lambdamikel/microtronic-2095-arduino-emulator/images/Arduino_UNO_R3_Pinout.jpg

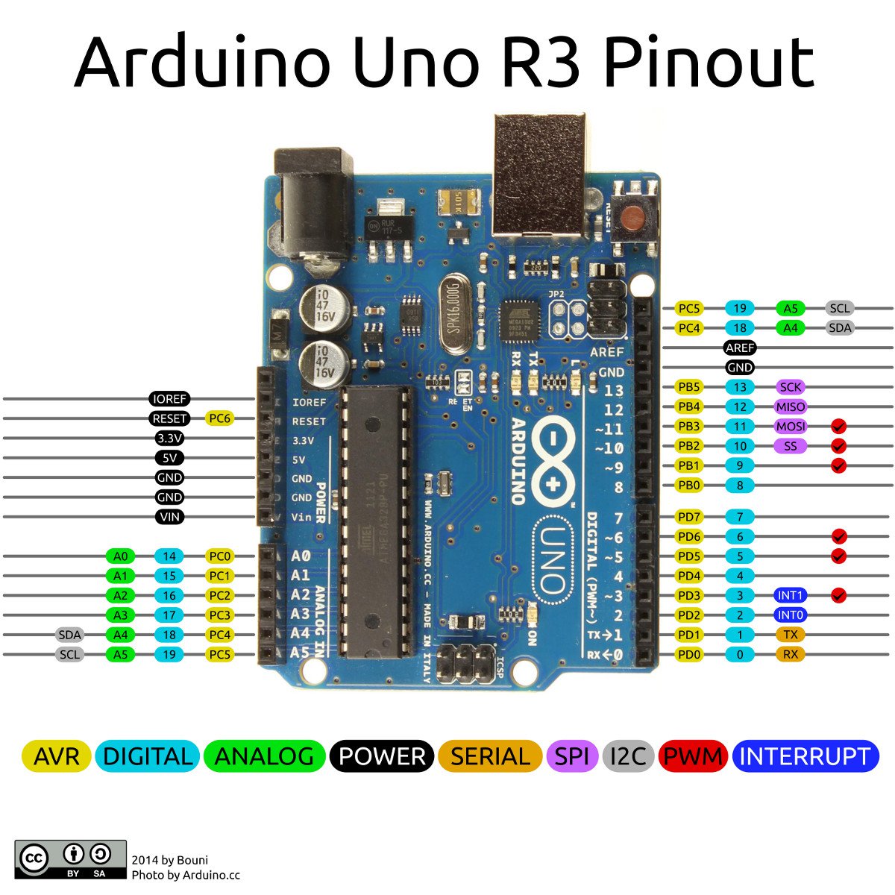
images/Arduino_UNO_R3_Pinout.jpg
