lambdamikel/microtronic-2095-arduino-emulator/images/busch-2090.jpg

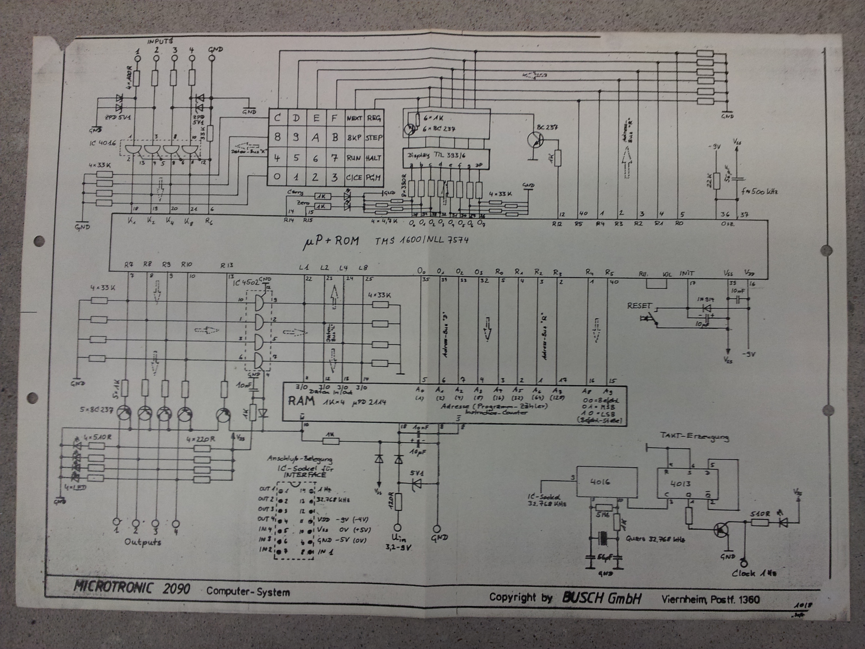
images/busch-2090.jpg
