lambdamikel/microtronic-2095-arduino-emulator/images/DSC06088.JPG

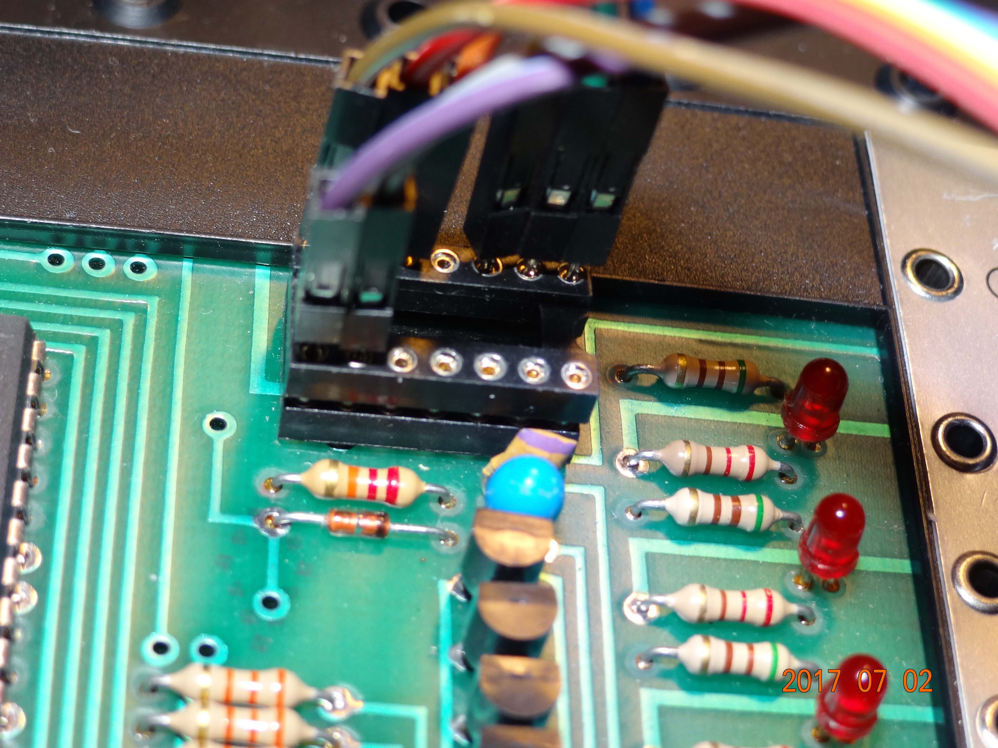
images/DSC06088.JPG
