lambdamikel/microtronic-2095-arduino-emulator/images/small/DSC06086.JPG

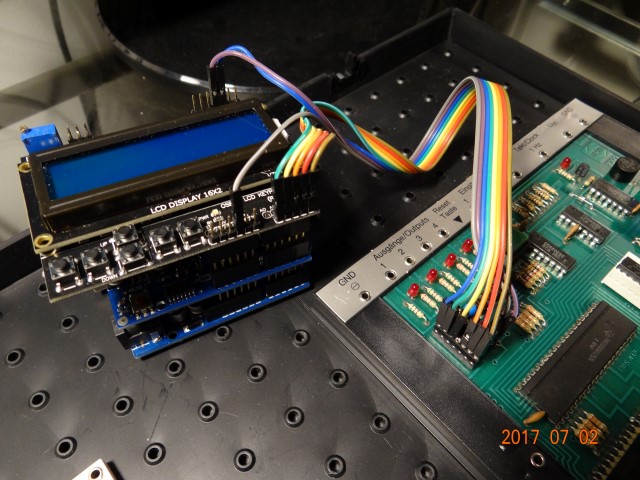
images/small/DSC06086.JPG
