lambdamikel/microtronic-2095-arduino-emulator/images/small/DSC06091.JPG

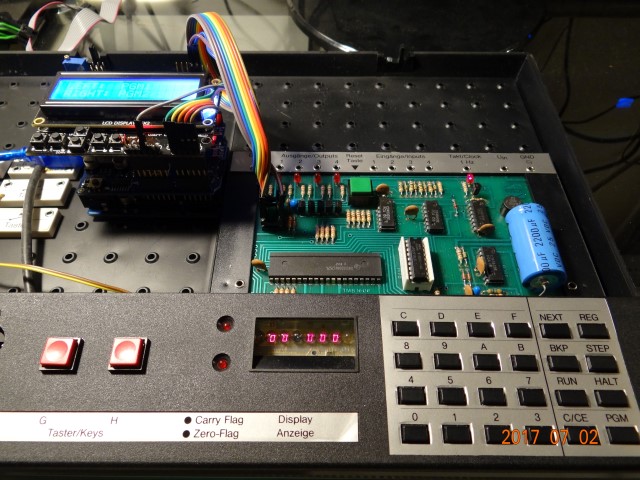
images/small/DSC06091.JPG
