lambdamikel/microtronic-2095-arduino-emulator/images/small/DSC06095.JPG

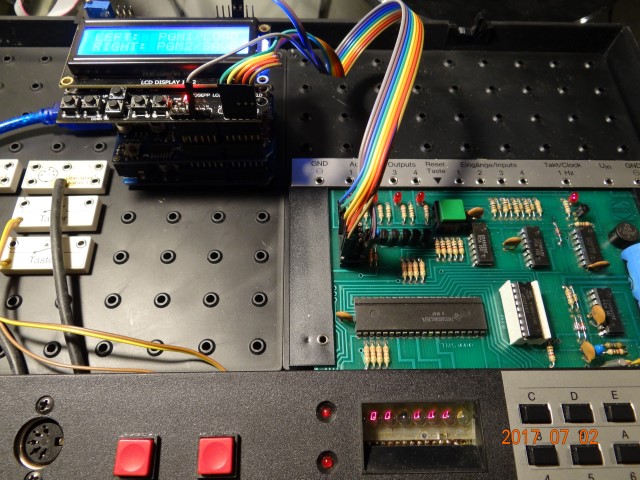
images/small/DSC06095.JPG
