lambdamikel/microtronic-2095-arduino-emulator/(commit log)

2017-07-04 Slight speed up for delays and resetPins().
    [busch2095.ino]
2017-07-13 Video (reverted from commit 8c613ff5ba84aeac15e57d6fa3e1a81566475664) Adding SdFat library for reference / version, Uno R3 pinput image, and Busch 2090 schematics. Video
2024-05-10 Tweaks for analog buttons read - LCD module. Adding analog button read test mode.
2024-06-22 HANOI.MIC corrected; somehow it got corrupted.
    [busch2095.ino]
